DawidAntosz/Spider_Robot_Project/README.md

# Spider Robot Project

<p align="center">
  
</p>

## Description
Robot design from years 2018/19 hence significant shortcomings in this design especially in the documentation and the written program. More information in the documentation directory.

Link to video project:

(https://youtu.be/R4VyKKDyfdw "Video")

<p align="center">
  
  
</p>

<p align="center">
  
</p>
<p align="center">
  
</p>

Project has won many awards, including a particularly distinguished third place in a national competition.

<p align="center">
  
  
</p>
