DawidAntosz/Spider_Robot_Project/Documentation/PAJĄK MECHATRONICZNY.pdf

# PAJĄK MECHATRONICZNY

## Spis treści:

1. Opis projektu
2. Wykaz elementów
3. Schemat połączeń elektrycznych
4. Instrukcja obsługi
5. Zdjęcia
- Modele 3D
- Symulacji w Python
- Rozpoznawania obiektów
- Transmisji wideo online
- Robot
6. Komunikacja w sieci komputerowej, protokół SSH
7. Magistrala I²C
8. Obliczenia oraz opis kinematyki robota
9. Wykrywanie obiektów
10.Zastosowanie w przemyśle
11.Program Arduino
12.Program symulacji w języku Python 13.Program komunikacja Arduino z Raspberry

## 1.Opis projektu

Projekt ten świetnie wykorzystuje połączenie elementów mechanicznych, współpracujących ze sobą komponentów elektronicznych oraz oprogramowania, w tym sensie czyniąc pozycję wartą dalszej lektury.

Przedstawiony robot kroczący wykorzystuje do realizacji ruchu operacje macierzowe dzięki którym może precyzyjnie określić pozycję i orientację każdego z członów robota w przestrzeni trójwymiarowej. Takie rozwiązanie realizacji ruchu jest aktualnie
wykorzystywane wśród wielu robotów przemysłowych.

Składający się z dwunastu serwomechanizmów sterowanych popularnym modułem Arduino Mega bazującym na mikrokontrolerze AVR ATmega2560, który z kolei połączony przez magistrale I²C z minikomputerem Raspberry Pi Zero WH z zamontowana kamerą na pokładzie umożliwia nam zarówno sterowanie robotem jak i dostęp do obrazu przed robotem, w czasie rzeczywistym z lekkim opóźnieniem z dowolnego miejsca w zasięgu naszego routera.

Dodatkowo nasz robot potrafi z dostarczanego przez kamerę obrazu wykrywać obiekty i je rozpoznawać. Metoda wykrywania obiektów należy do metod opartych na głębokim uczeniu się. Wykorzystuje do tego celu otwarto źródłową bibliotekę programistyczną napisaną przez Google Brain Team, nazwaną TensorFlow, która to właśnie wykorzystuje sztuczne sieci neuronowe, które mogą wydobywać z danych zawartych w dostarczanym obrazie wzory oraz modele rozpatrywanego przedmiotu.

Konstrukcja robota została w całości zaprojektowana w programie Inventor Autodesk i wykonana w technologii druku 3D. Materiał jaki został użyty do tego celu to ABS, znacznie bardziej odporny na wyższą temperaturę, przez co też łatwiejszy w obróbce ręcznej. Jedną z zalet tego materiału jest także dość duża odporność na pęknięcia i stosunkowo duża twardość przez co wybór padł na ten rodzaj materiału.

Dodatkiem do kamery jest płytka na której zamieszczone jest sześć diod świecących, dzięki czemu kamera z w przypadku braku światła dalej może wysyłać obraz. Dzięki fotorezystorowi zamieszczonemu nad kamerką można określić graniczną wartość napięcia, które przepuszcza nasz element światłoczuły wprost proporcjonalnie do natężenia oświetlenia w otoczeniu przy której diody zaczynają świecić.

## 2.Wykaz elementów

- Rasberry Pi Zero WH - model togo minikomputera posiada procesor Broadcom BCM2835 1 GHz i 512 MB pamięci RAM dodatkowo został wyposażony w moduł Wi-Fi, Bluetooth, czterdzieści pinów ogólnego przeznaczenia oraz złącze kamery CSI . System operacyjny jaki został użyty to Linux, a wchodząc w szczegóły jedna z dystrybucji Linuxa oparta na Debianie jaką jest Raspbianstretch.
- Arduino Mega 2560 – Jedna z wersji popularnego Arduino płytka posiada mikrokontroler ATmega2560, do wykorzystania 256 kB pamięci Flash, 8 kB RAM, 54 cyfrowych wejść/wyjść z czego 15 można wykorzystać jako kanały PWM, które zostały użyte do sterowania serwomechanizmami, mamy też 16 wejść analogowych.
- Kamera, którą robot posiada to - Raspberry Pi Camera HD v2, która wyposażona jest w matrycę o rozdzielczości 8 Mpx, wspiera tryb nagrywania HD 1080p, 720p oraz 640 x 480p, potrafi wykonywać zdjęcia w jakości 3280 x 2464 px. Raspberry posiada sprzętowe wsparcie dla obsługi tej kamery, dzięki temu urządzenie nie zużywa mocy obliczeniowej procesora. Nie wymaga instalacji sterowników dla systemu Raspbian.
- Serwomechanizmy użyte w projekcie to konkretny model -Serwo PowerHD HD-1800A ich napięcie zasilania jest w zakresie od 4,8 V do 6,0 V. Zakres ruchu: od 0 ° do 180 °. Moment siły oraz prędkość zależy od parametrów zasilania w robocie zasilanie dla serwomechanizmów ustawione jest na 6,0V z tego względu aby uzyskać większy moment, co też daje nammoment siły: 1,3 kg*cm (0,12 Nm) oraz prędkość: 0,08 s/60°. Robot posiada ich w sumie dwanaście, a na każdą nogę przypada ich trzy.
- Zasilanie. Za źródło zasilania posłużyły mi ogniwa litowo-polimerowe. Połączenie ogniw w sposób2S2P, dzięki temu uzyskuje napięcie około 8,0V i pojemność 3Ah
- Przetwornice napięcia - Arduino a także Raspberry potrzebują do pracy napięcia 5,0V. Serwomechanizmy tak jak już wcześniej wspomniałem pracują przy 6,0V chociaż przy wyższym napięciu nic im się złego nie dzieje to jednak z tego względu, że podczas projektowania mogło dojść do zablokowania którejś z nóg, w wyniku czego przy wyższym napięciu układ sterowniczy takiego serwomechanizmu mógł się uszkodzić, wynikła konieczność użycia dodatkowych dwóch przetwornic step-down, które obniżają napięcie zasilania do poziomu pożądanego.
- Dwa przełączniki, jeden służy do załączenia zasilania na obydwie przetwornice tym samym zasilamy już Arduino i Raspberry, z kolei drugi przepuszcza nam napięcie z przetwornicy 6,0V do zasilania serwomechanizmów, takie rozwiązanie pozwala nam na odłączenie serwomechanizmów w dowolnym momencie bez konieczności wyłączania Raspberry.
- Fotorezystor 5-10kΩ GL5616

## 3.Schemat połączeń elektrycznych

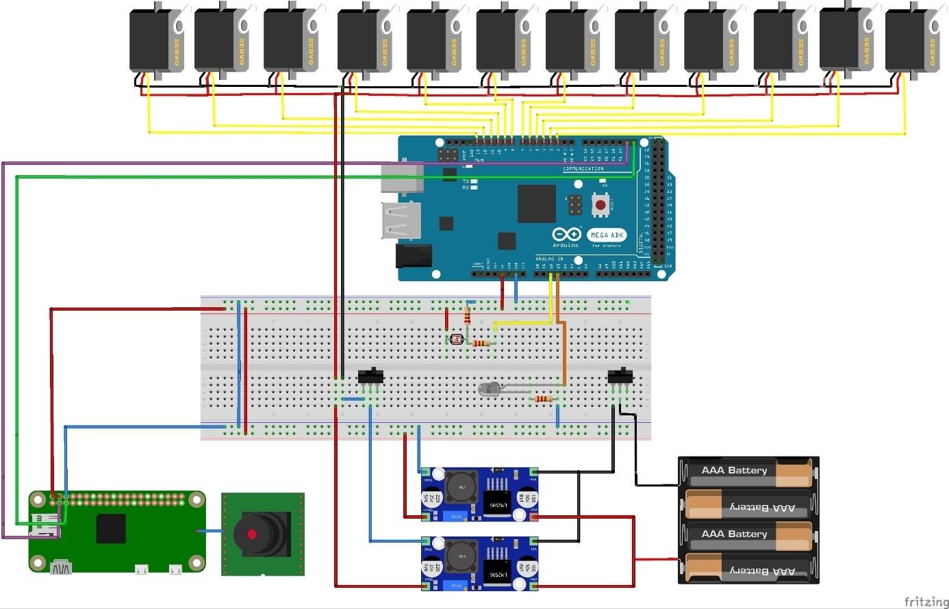
[picture p1: figure]

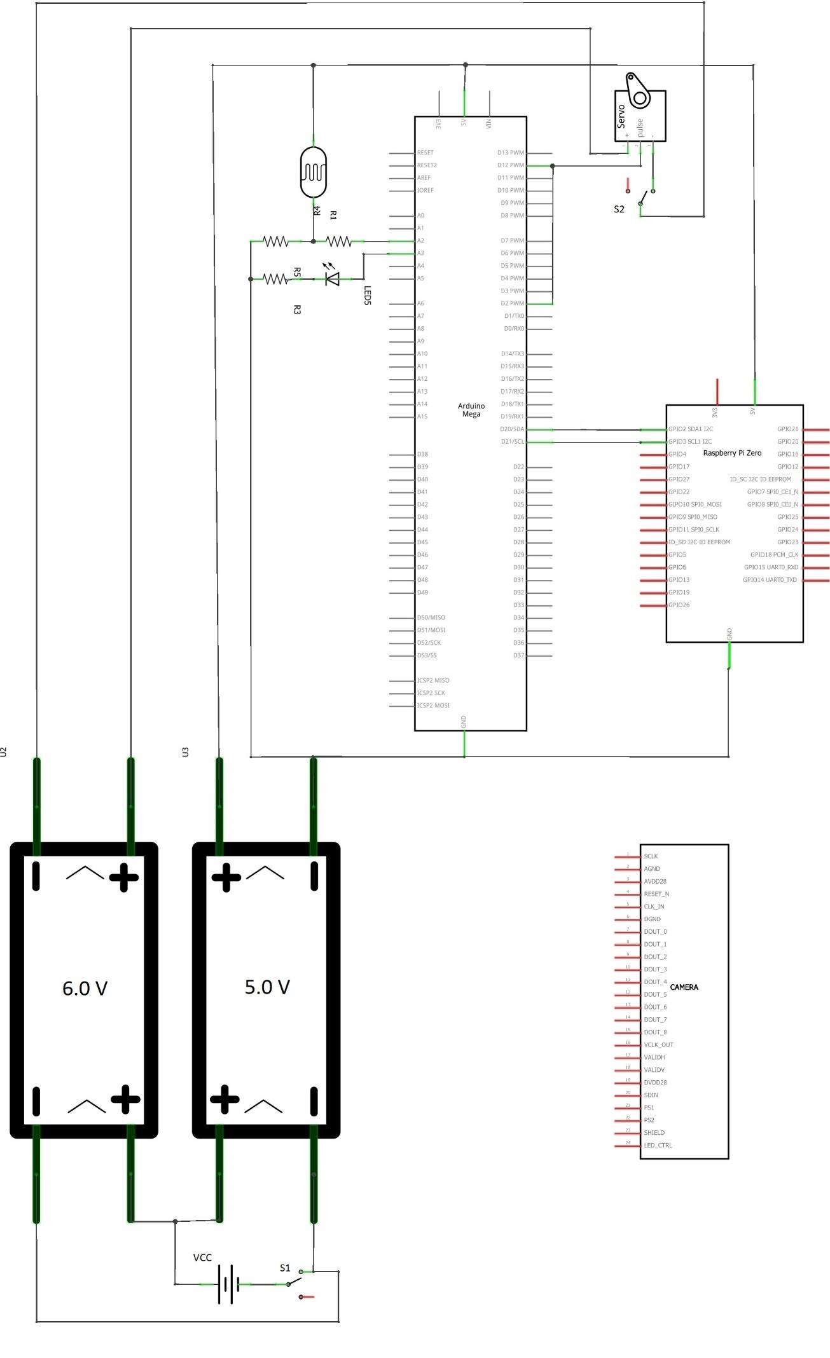
[picture p2: figure]

## 4. Instrukcja obsługi

a. Aby uruchomić robota musimy przełączyć dwa przełączniki znajdujące się w górnej części korpusu.
b. Żeby nawiązać połączenie z Raspberry potrzebujemy mieć na swoim komputerze zainstalowany program do komunikacji PuTTY. (https://www.chiark.greenend.org.uk/~sgtatham/putty/latest.html) Putty to standarowy klient SSH na systemy Windows/Linux , służy do terminalowego łączenia się ze zdalnymi komputerami.
c. Kolejno co musimy zrobić to dowiedzieć się jaki adres IP ma nasz minikomputer, wchodzimy w menu start i wpisujemy cmd potwierdzamy Enter, kiedy otworzy nam się konsola wpisujemy „ arp -a ” wtedy wyświetlają nam się adresy IP wszystkich podłączonych urządzeń z naszym routerem. Raspberry rozpoznamy po adresie Mac, który będzie zaczynać się od ciągu„b8-27-eb”.
d. Kiedy wiemy już jaki adres IP ma Raspberry włączamy program Putty. Domyślnie mamy ustawioną pierwszą z kategorii oraz zaznaczone SSH. W linijce pod nazwą „Host Name” wpisujemy adres IP naszego Raspberry i potwierdzamy Enter.
e. Gdy Raspberry nawiąże komunikacje z naszym komputerem musimy się do niego zalogować. Login „pi” hasło „8054”, po chwili otworzy nam się konsola.
f. Aby móc sterować robotem wpisujemy w konsoli „python ardu.py” uruchomimy program, który służy do komunikacji miedzy Arduino i Raspberry, który również jest dołączony do dokumentacji.
g. Uruchomionym programem możemy sterować ruchem robota wpisując, co chcemy żeby robot zrobił i zatwierdzamy Enter.
- „w” / „s” – idź do przodu /idź do tyłu
- „a” /d” – idź w lewo / idź w prawo
- „z”/ „x” – siedź / wstań
- „c”/ „n” – pomachaj
- „m”/ „l”– przód / dół do góry
- „z” – robot wykonuje przykładową sekwencje ruchów
- „f” – pozycja początkowa
- „v”- wyłączamy program
h. Wpisując w przeglądarce internetowej „IP Raspberry:8081” i potwierdzając Enter ładuje nam się obraz z kamerki robota. Usługa została tak ustawiona, aby uruchamiała się zaraz po starcie systemu. Możemy ją wyłączyć wpisując w konsoli – „sudo service motion stop” aby ponownie uruchomić wpisujemy to samo tylko zamiast „stop” wpisujemy „start” przydatne jest czasem także zrestartowanie usługi wiec, żeby to zrobić postępujemy tak samo tylko końcówka „restart”.
i. Jeśli chcielibyśmy uruchomić rozpoznawanie obiektów musimy zainstalować protokół VNC. (https://www.realvnc.com/en/connect/download/viewer/) Służy on do wirtualnego przekazywania obrazu pulpitu Raspberry. Kolejno wpisujemy adres IP i logujemy się gdy już otworzy nam się pulpit naszego minikomputera w lewym górnym rogu znajdziemy coś na wzór menu, potwierdzamy, wchodzimy w zakładkę „System tools” i wybieramy „UXterm” w podpunkcie zdjęcia dałączam screena.
j. Otworzy nam się terminal. Aby go uruchomić musimy przede wszystkim wyłączyć nasz obraz z kamerki na przeglądarce kamera musi być zwolniona z jakichkolwiek procesów. Tak więc „sudo service motion stop” kolejno wpisujemy dwie komendy – „cd tensorflow1/models/research/object_detection” wchodzimy tym samym w folder z programem „Object_detection_picamera.py”. Jeśli chcemy z tego folderu wyjść wystarczy wpisać „cd”. Gdy jesteśmy już w folderze to prawie identycznie jak programem do sterowania uruchamiamy „python3 Object_detection_picamera.py” po chwili otwiera nam się okno z obrazem z przed kamery… tutaj już ciężko jest mówić o sam obraz jest to bardziej to co komputer rozpoznał poprzez swoje algorytmy.
k. Aby wyłączyć program najeżdżamy na krzyżyk okna programu, następnie klikamy w okno konsoli i wciskamy Ctr+Z.
l. Raspberry wyłączamy poprzez wpisanie w konsoli „sudoshutdownnow” bądź w menu start na dole znajdziemy „Shutdown”.

## 5. Zdjęcia

## - Modele 3D

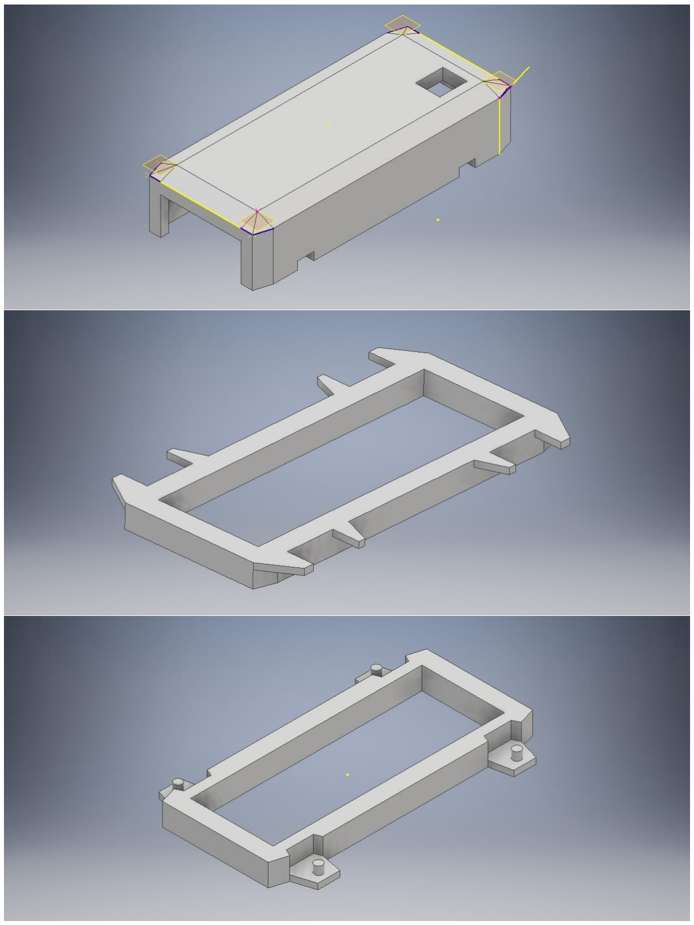
[picture p3: figure]
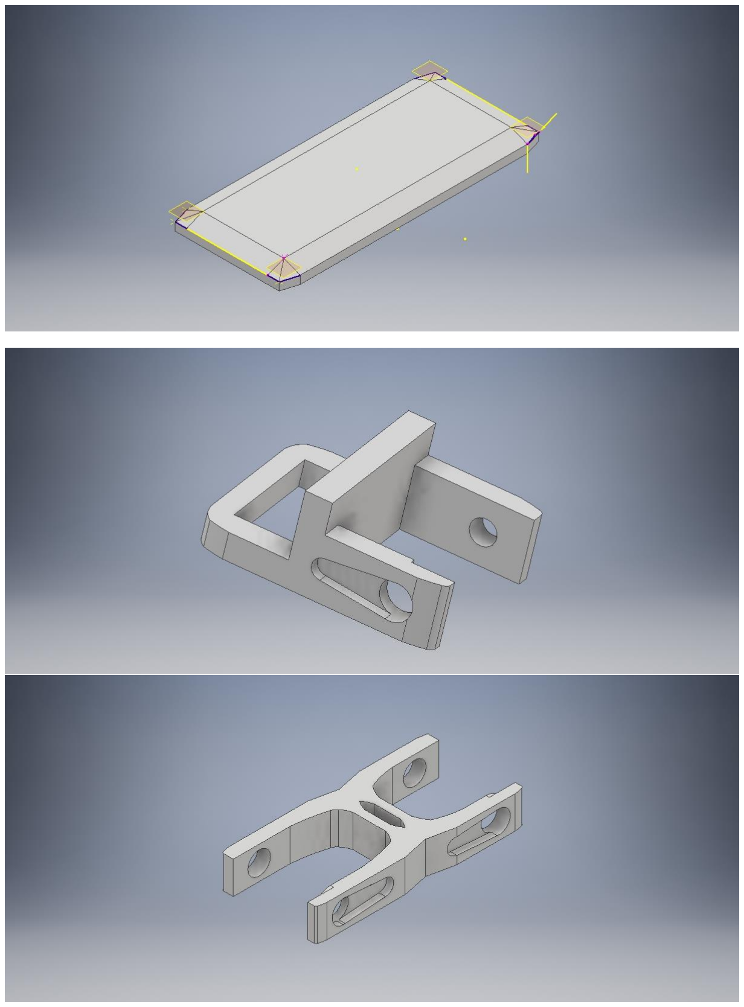
[picture p4: page 12]

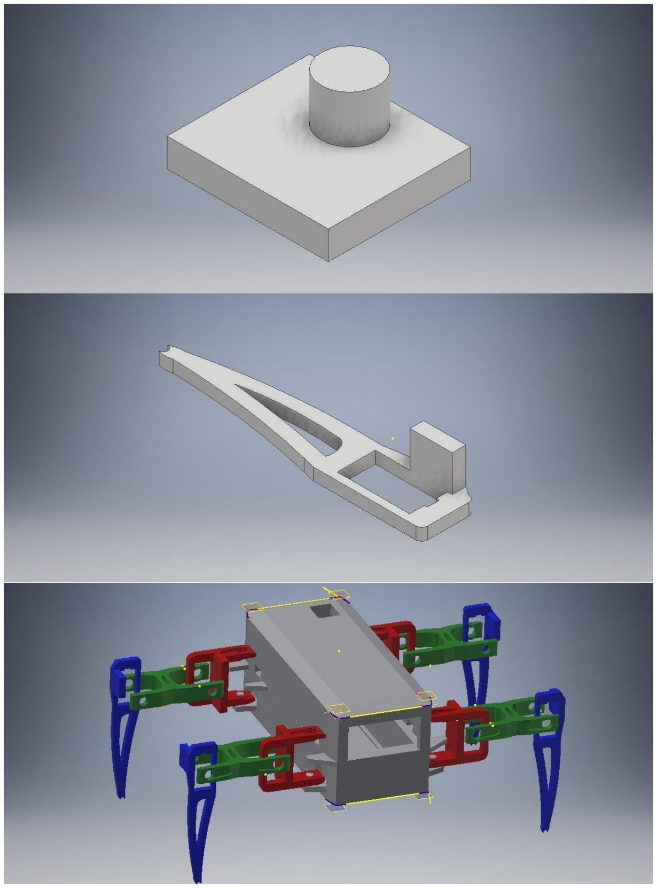
[picture p5: figure]

## - Symulacja w Python

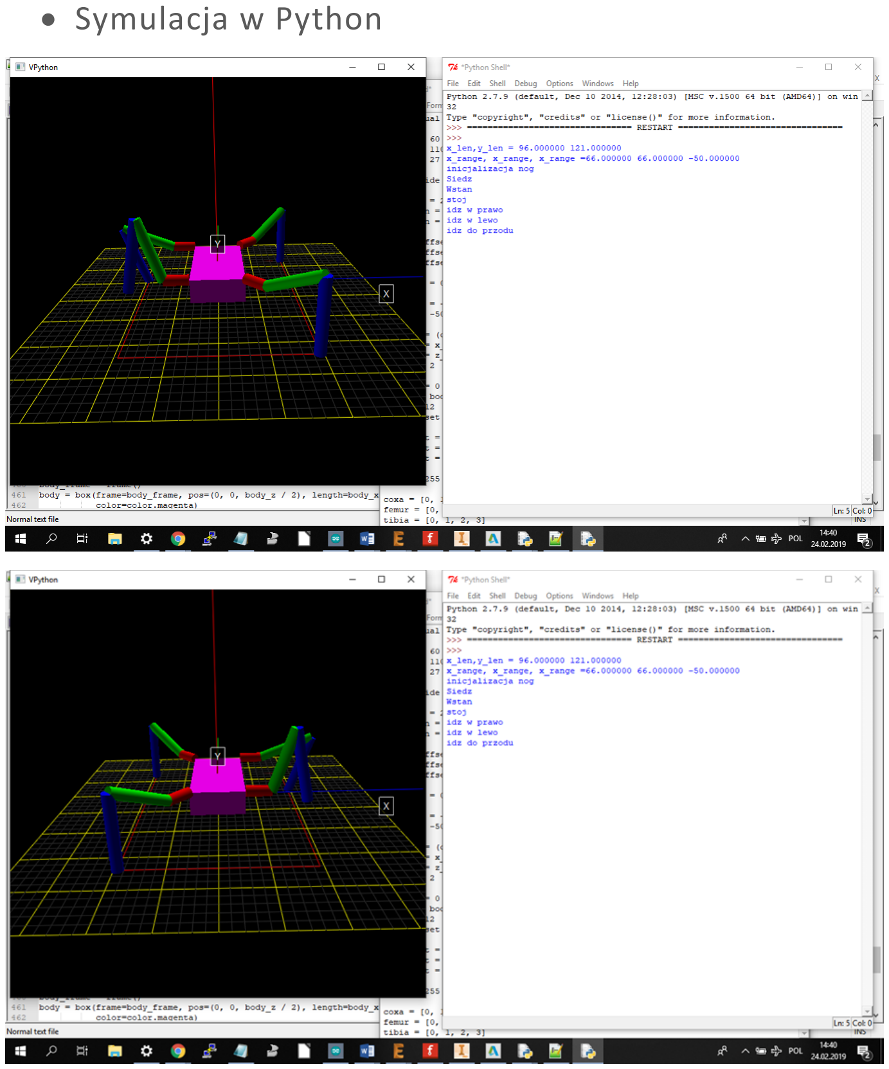
[picture p6: page 14]

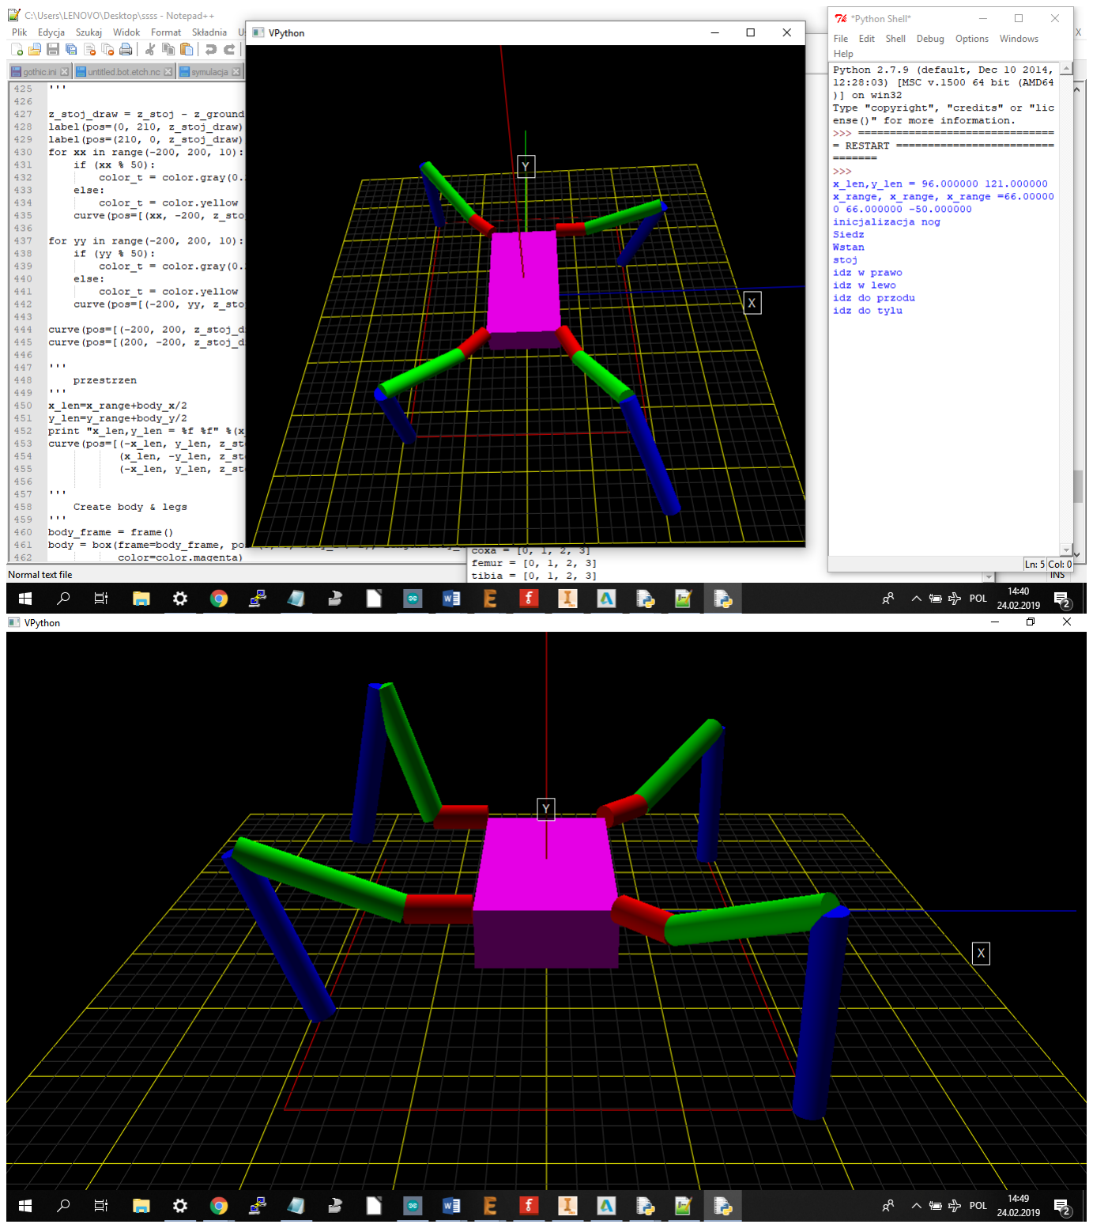
[picture p7: figure]

## - Rozpoznawanie obiektów

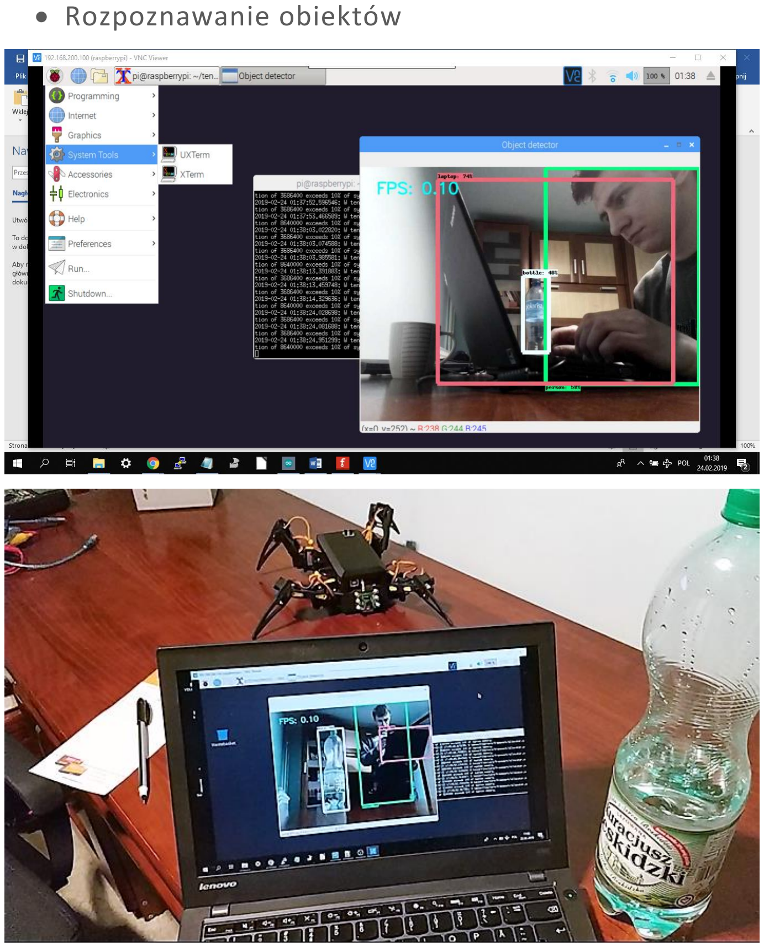
[picture p8: page 16]
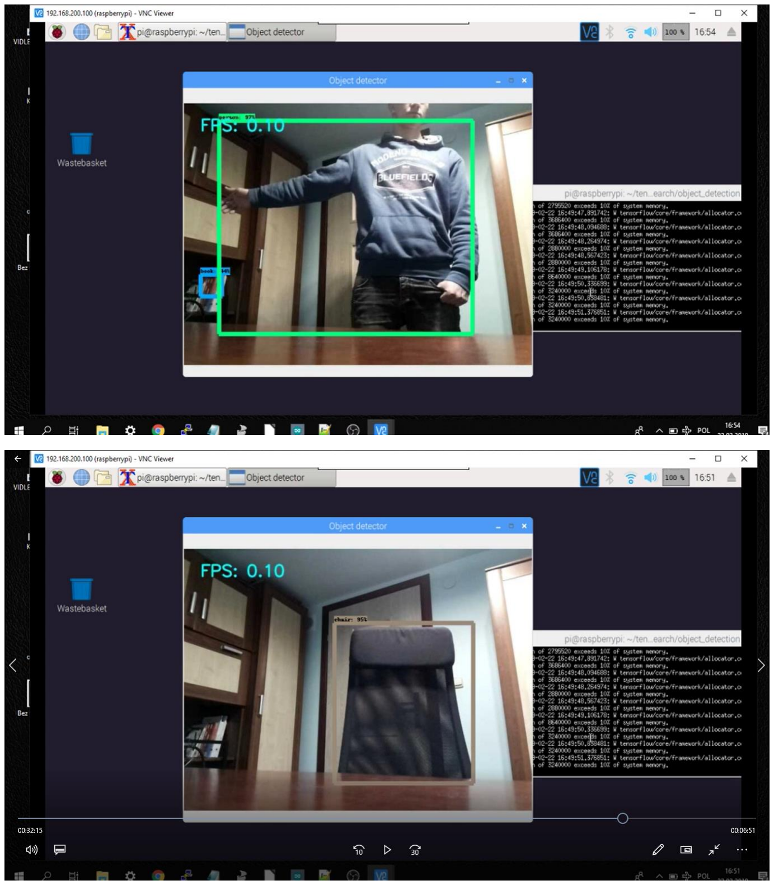
[picture p9: page 17]

## - Transmisja wideo online

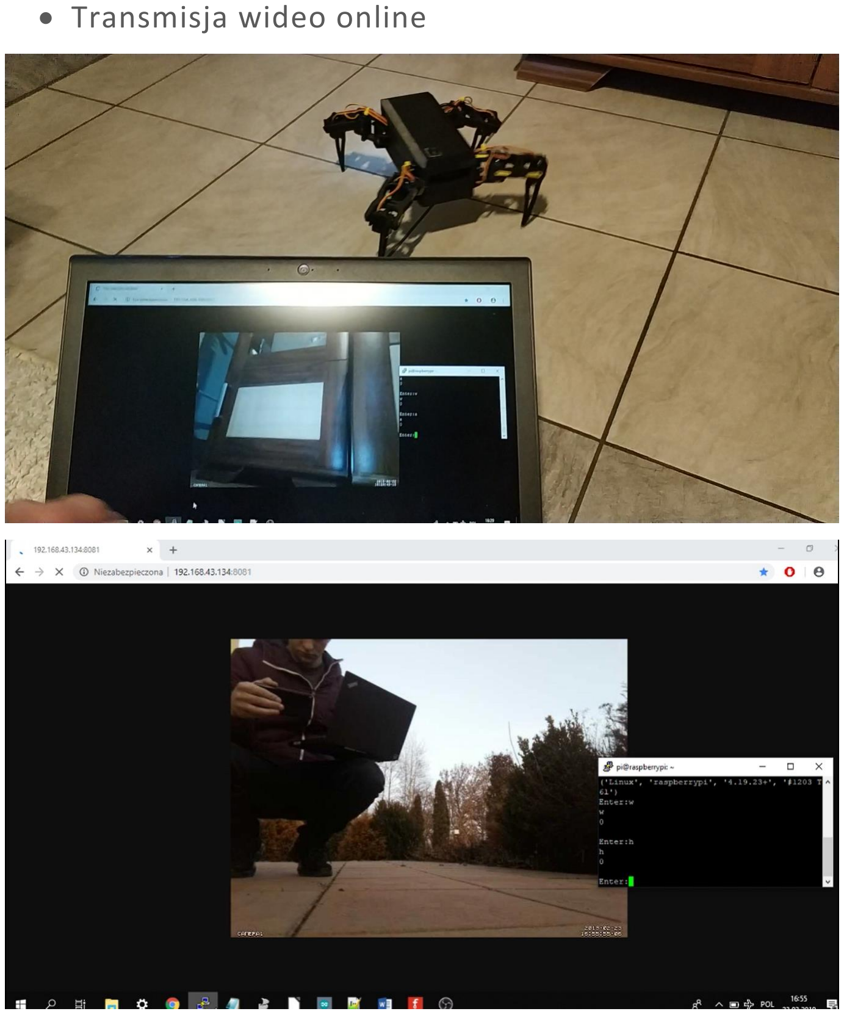
[picture p10: page 18]
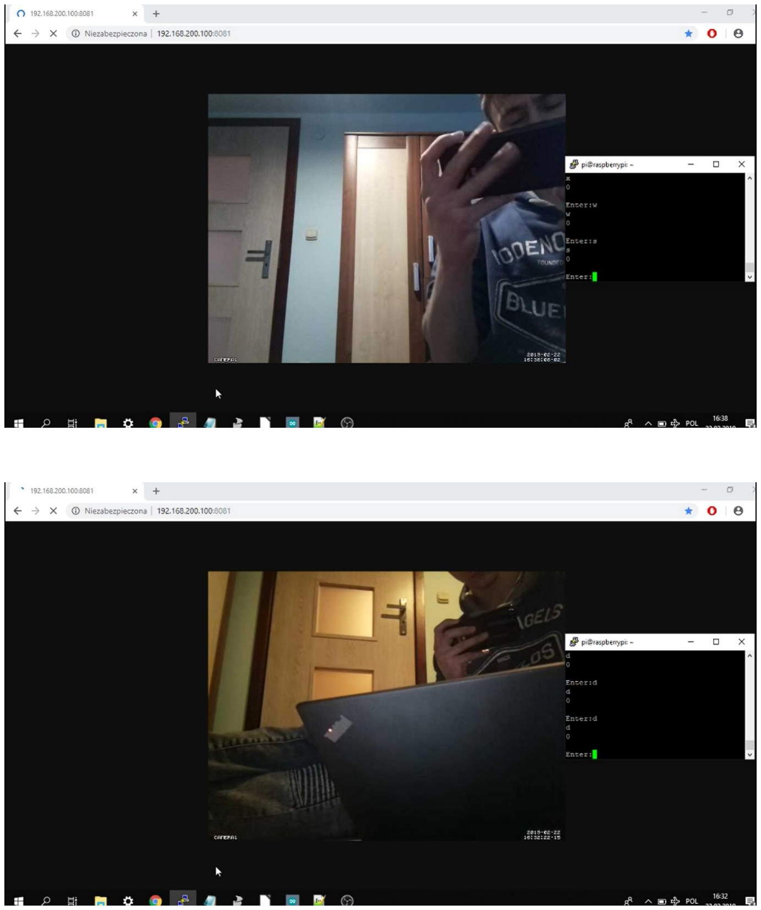
[picture p11: page 19]

## - Robot

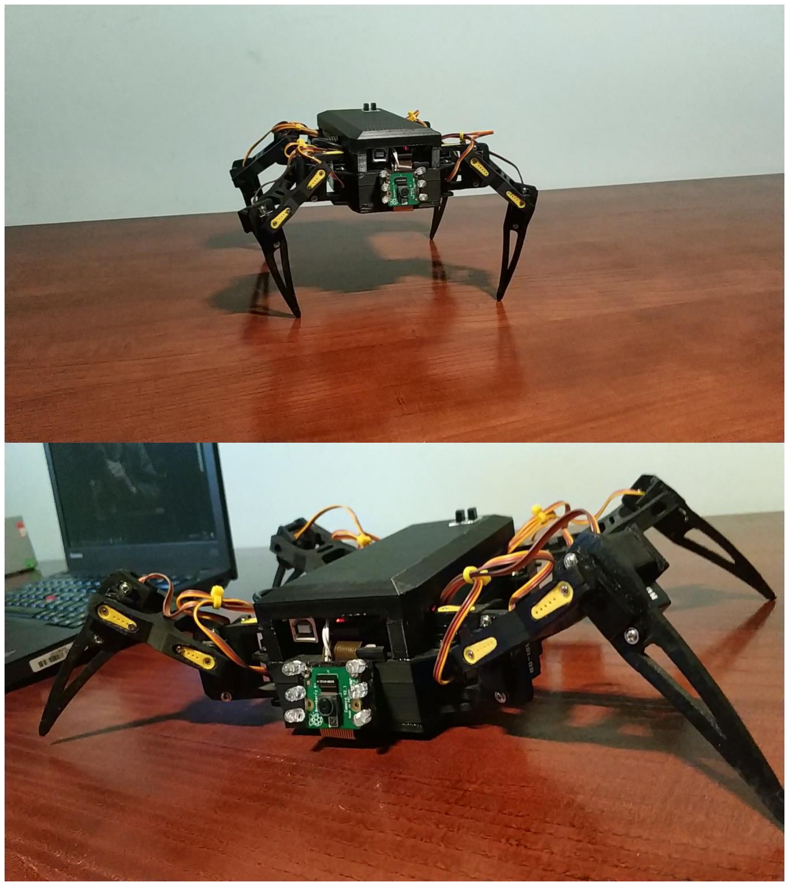
[picture p12: figure]

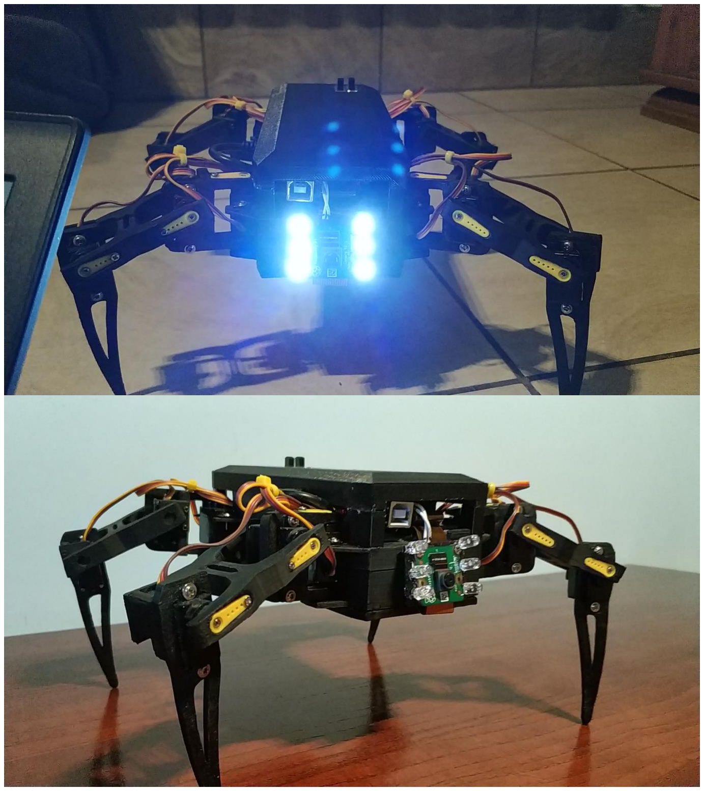
[picture p13: figure]
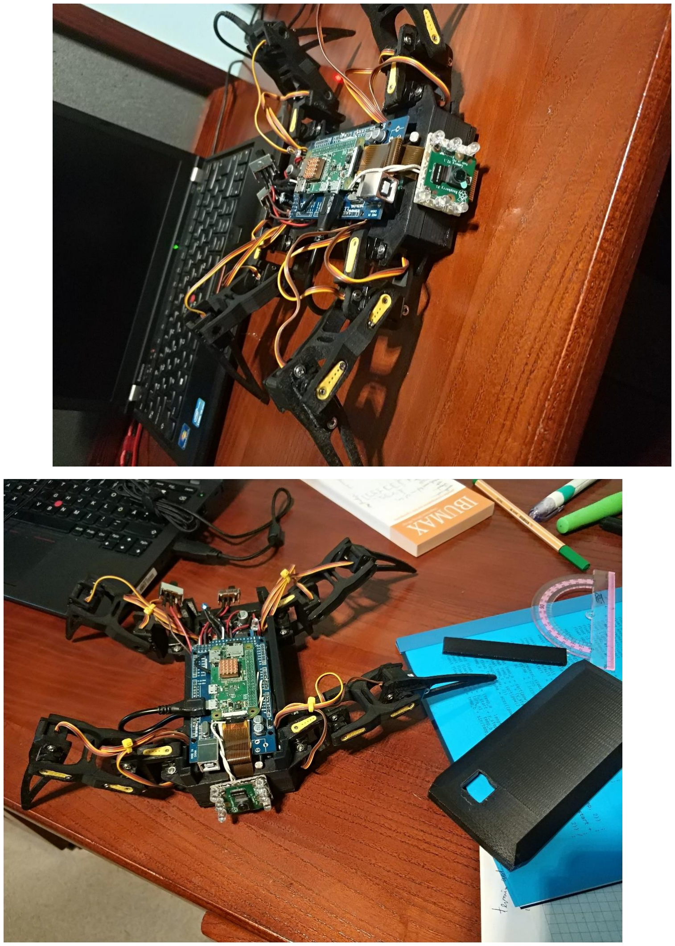
[picture p14: page 22]

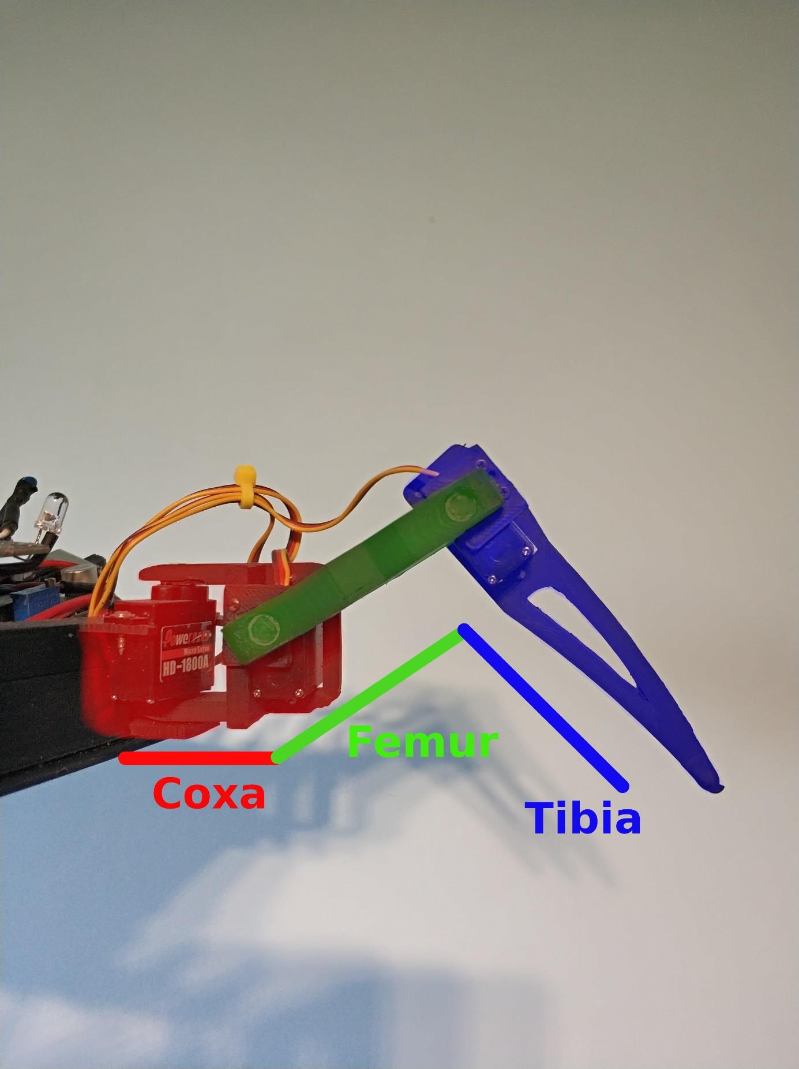
[picture p15: figure]

## 6.Komunikacja w sieci komputerowej, protokół SSH

Często wykorzystywany protokół warstwy aplikacji, to protokół zdalnego zarządzania hostami, zwany SSH. Jest to standardowy protokół komunikacyjny używany w sieciach komputerowych TCP/IP. SSH jest następcą protokołu Telnet i służy on do terminalowego łączenia się ze zdalnymi komputerami. SSH różni się od Telnetu tym, że transfer wszelkich danych jest zaszyfrowany oraz możliwe jest rozpoznawanie użytkownika na wiele sposobów.

W projekcie program, w którym nawiązuje komunikacje z Raspberry nazywa się PuTTY. PuTTY emuluje terminal tekstowy, co pozwala w łatwy sposób łączyć się z serwerem za pomocą wybranego protokołu jakim jest SSH.

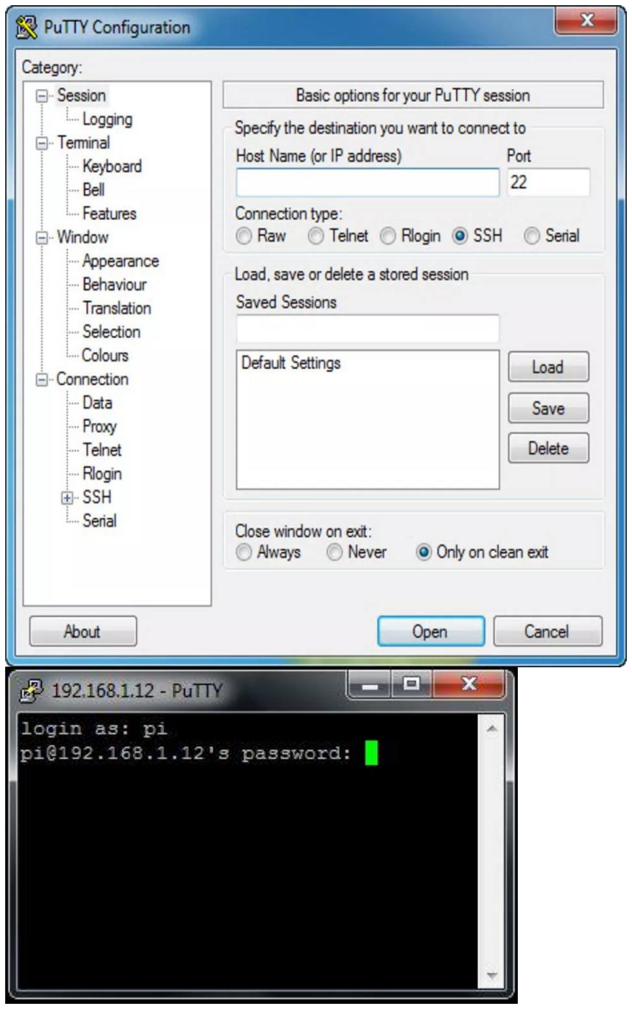
[picture p16: figure]

## 7. Magistrala I²C

Połączenie Arduino z Raspberry wydaje się być najbardziej przestronne jeśli chodzi o możliwości jakie przez integracje tych dwóch platform możemy uzyskać, ale również takie zestawienie jest najbardziej budżetowym rozwiązaniem.

Bardzo popularny interfejs komunikacyjny jakim możemy obsłużyć za pomocą tylko 2 linii aż 127 urządzeń jest I²C.Magistrala I²C to szeregowa dwukierunkowa magistrala służąca do przesyłania danych. Korzysta ona w tym celu tylko z dwóch pinów co jest oczywistą zaletą tego sposobu komunikacji. SCL -pin przez który przesyłany jest sygnał zegarowy, SDA - pin przez który przesyłane są dane.

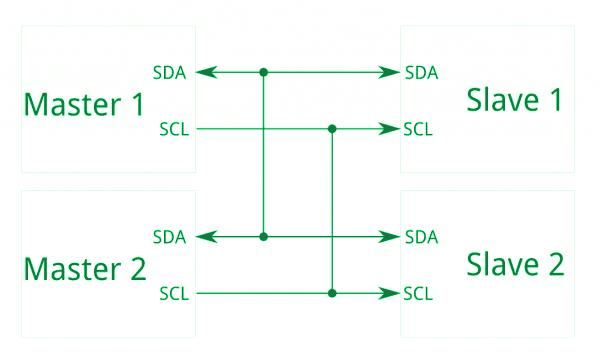
[picture p17: figure]

Magistrala I²C przesyła dane w sposób synchroniczny, synchronizowany za pomocą sygnału zegarowego podawanego na pinie SCL. Komunikacja I²C działa w układzie Master, Slave, to znaczy że jedno urządzenie jest nadrzędne i steruje urządzeniem podrzędnym, które ma określony adres do którego Master czyli nasze urządzenie nadrzędne musi się odnieść. Możliwe jest przez to sterowanie wieloma urządzeniami podrzędnymi. W programie dla Arduino funkcja która odbiera dane spod zdefiniowanego wcześniej adresu nazywa się „receiveEvent” i odbiera dane w postaci koduASCII czyli siedmiobitowego systemu kodowania znaków, używanego aktualnie we współczesnych komputerach.

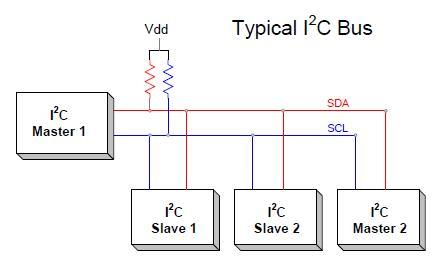
[picture p18: figure]

## 8.Obliczenia oraz opis kinematyki robota

Tak jak na wstępie zostało wspomniane, robot do realizacji ruchu korzysta z operacji matematycznych, przez które za pomocą macierzy przedstawia algorytm przemieszczenia, umożliwiając wyznaczenie położenia punktu końcowego w przestrzeni trójwymiarowej przechodząc przez poszczególne punkty pośrednie.

W robotyce bardzo często wykorzystuje się notację Denavita-Hartenberga umożliwia nam ona wyznaczenie równań kinematyki robota znając dane o zmiennych przegubowych możemy określić orientacje końcówki roboczej.

Wyznaczenie pozycji i orientacji chwytaka na podstawie współrzędnych przegubowych to zadanie proste kinematyki. Najłatwiej będzie zacząć od przedstawienia tak prostego manipulatora dwuczłonowego.

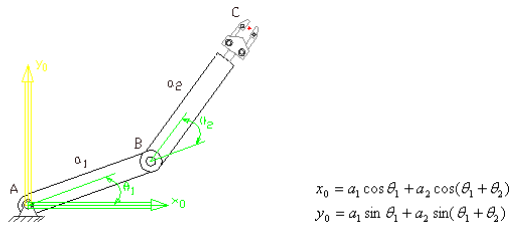
[picture p19: figure]

Przedstawione działania pozwalaja określić położenie punktu C dla poszczególnych osi X0 i Y0 znajac kąty oraz długoście poszczególnych członów manipulatora.

Gdybyśmy chcieli rozważyć ten sam problem stosując notację Denavita-Hartenberga musielibyśmy wyobrazić sobie dodatkową oś Z0 w naszym układzie współrzędnych oraz dodatkowe układy współrzędnych znajdujące przy każdym z członów robota.
Jedną z zasad jakie musimy przyjąć to ta, że obrót poszczególnych członów ramienia odbywa się względem osi Z, a przemieszczenie względem osi Z, a X.

Zgodnie z notacją należy przygotować tabele wraz z wypisanymi z parametrami kinematycznymi, takimi jak kąty obrotu, przemieszczenia członów oraz długości poszczególnych ramion. Przy parametrach które ulegają zmianie w czasie znajduje się indeks var.

Połączenie | tii | Di | Ai | αi
1 | ti1, var | 0 | A1 | 0

2 | ti2, var | 0 | A2 | 0

Rozpatrywany przez nas manipulator płaski o dwóch stopniach swobody musimy przesunąć pomiędzy poszczególnymi układami współrzednych, tak aby pomiedzy tym przesunięciem był tylko jeden parametr zmienny, a kolejno musimy rozpisac macierze przekształcenia jednorodnego dla poszczególnych członów, a wyglądaja one tak.

Dla pierwszego połączenia

Dla drugiego połączenia

Mając zdefiniowane dwie macierze dla poszczególnych połączeń możemy ostatecznie wyciągnąć macież transformacji bedącą główną macieżą układu Y0 X0

Porównując równania przytoczone na samym początku możemy wywynioskować, że położenia chwytaka z obliczeń wychodzą identyczne jak w przypadku naszej wyjsciowej macierzy.

Na tym relatywnie prostym przykładzie na chwilę przystaniemy abym mógł przytoczyć całościową macierz ruchu naszego robota, która jest bogatsza o macierz ruchu wektora w przestrzeni euklidesowej to znaczy, że uwzględnia odwrócenia punktu docelowego,a odwrócenie, punktu może zmienić chiralność, to znaczy zmienić prawy układ współrzędnych na lewy układ współrzędnych lub też na odwrót.

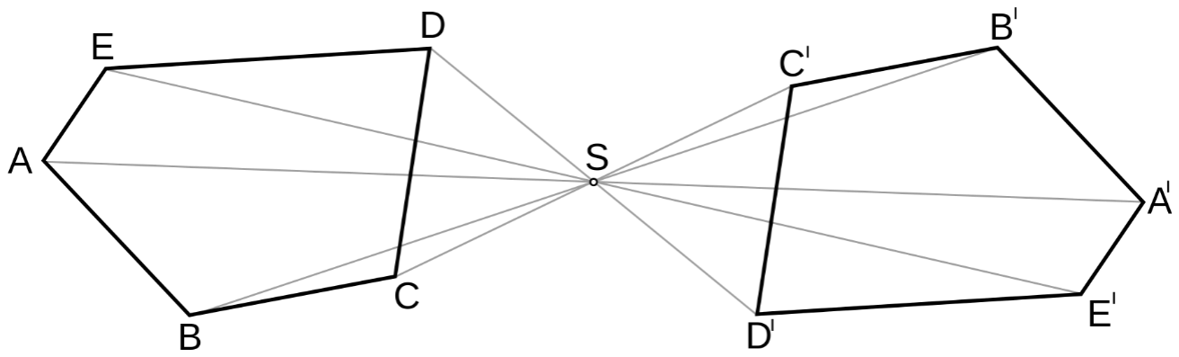
[picture p20: figure]

Cała rotacja plus inwersja tworzy zbiór macierzy ortogonalnych.

Tak całościowo już po wszelkich przejściach wygląda macierz robota

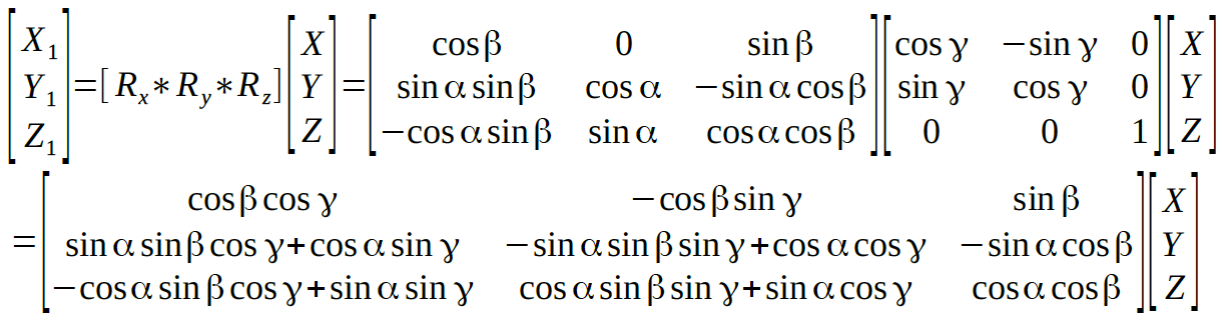
[picture p21: figure]

Obrót elementarny, czyli taki wokół dowolnej osi układu współrzednyc wygląda tak:

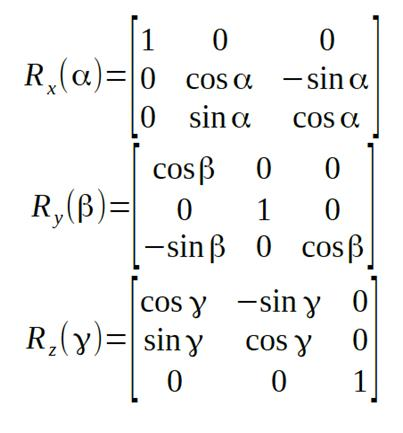
[picture p22: figure]

Każda z tych macierzy obraca wektory kolumnowe przeciwnie do ruchu wskazówek zegara, jeśli spełniony jest któryś z warunków: oś obrotu kieruje się w stronę obserwatora, układ współrzędnych jest prawoskrętny, kąt obrotu ti jest dodatni.

Program jaki obsługuje Arduino znajduje się w „Załaczniku 1”. Z racji tego, że kod jest dość długi i mimo starań nie jest na tyle klarowny by zrozumieć go od ręki, jego tok postępowania pozwolę sobie rozwinąć po krótce w tym miejscu.

Myślę że najwygodniej będzie zacząć patrząc już od elementu wykonawczego, serwomechanizmy swoje położenie wyznaczają poprzez odbiór co 20 ms sygnału długości 900-1500ms i ustawiają się stosownie do długości impulsu. Tak więc mamy zdefiniowaną tablicę, w której są wpisane nazwy pinów do których są podłączone serwomechanizmy „servo_pin[4][3]”. Właśnie na te piny przypisywane są określone wartości przez funkcje „biegun_dla_serw”. Funkcja ta pobiera dane takie jak alpha, beta, gamm, które są danymi przeliczonymi ze współrzednych kartezjańskich na biegun, to znaczy na odpowiednią wartość, którą możemy serwo ustawić. Funkcją odpowiadającą za wyliczenia danych takie jak, alpha, beta, gamma nazywa się „kartezjanski_na_biegunowy” i wykonuje potrzebne do tego obliczenia. Obie te funkcje są wywoływane przez funkcje „Serwa”, w której wywołana jest funkcja przerwań ustalająca w jakim czasie ma wykonać się przemieszczenie oraz ustawione zmienne statyczne, czyli widoczne tylko dla tej funkcji alpha, beta, gamma. Przez porównanie położeń funkcja przepisuje właśnie wartości do powyższych funkcji.

Główna funkcja programu czyli „setup” wpisuje wartości dla położenie początkowego odnosząc się do funkcji „ustawienie ” o której będzie zaraz, czyli po uruchomieniu arduino ustawiane są nogi robota na określone położenie póżniej mamy inkrementacje położenia czyli dla każdej nogi ustawiane jest kolejne położenie mamy tam zapis położenie teraz = położenie właściwe i są to tablice z wartościami kolejnych liczb wywołanych przez inkrementacje w pętli „for” i jest to niejako powielenie funkcji „czekaj” która też będzie omówiona, a na końcu wywołujemy przerwanie w milisekundach dla funkcji „Serwa”. Idąc logiczną kolejnościąw dalszej cześć mamy funkcję, która już dla danego ruchu ustawia poszczególne wartości i nazywa się ona „ustawienie” i właśnie w niej obliczane jest po przyjęciu danych zewnętrznych, które dla określinego ruchu są w nią wpisywane przez sekwencje ruchu jaką chcemy wykonać. Jej nieodłączną funkcją wykonywaną w danej sekwencji ruchu jest funkcja o nazwie „czekaj” i porównuje ona wartości bedące w wewnątrz tablicowych położeniach w danej chwili do położeń pożadanych. W pętli głównej naszego programu najistotniejsze jest postawienie nazwanej przeze mnie „flagowa_przeszkoda” przypisanie do niej jakiejś wartości pozwala na określenie wykonania funkcji.

Pragnę zaznaczyć że wszelkie obliczenia w szerszym aspekcie są zapisane w programie,tutaj jedynie pobieżnie przedstawiam logikę działania.

## 9. Wykrywanie obiektów

W tym podpunkcie na samym początku opiszę jak całościowo zostały zaimplementowane i użyte biblioteki do wykrywania obiektów kolejno wgłębię się w zasadę działania czysto teoretyczną, ponieważ temat jest bardzo rozległy będzie to omówione w znacznym skrócie.

Tak więc jak na samym wstępie było powiedziane, że głównym silnikiem procesu jest biblioteka TensorFlowi, potrafi ona nie tylko rozpoznawać obraz lecz także analizować mowę. Żeby zrozumieć zasadę działania TensorFlow trzeba zapoznać się z teorią grafu skierowanego ilustracja przedstawia właśnie przykładowy graf.

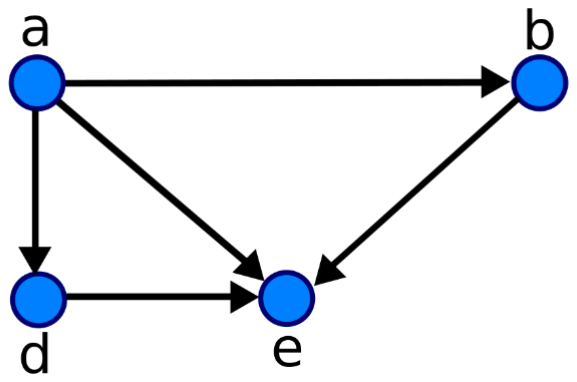
[picture p23: figure]

Jego wierzchołki to matematyczne operacje lub punkty, w których dochodzi do wymiany danych, zaś krawędzie opisują relacje wejścia/wyjścia pomiędzy węzłami, przedstawione w formie dynamicznych wielowymiarowych macierzy danych. Udostępniona przez Google biblioteka programistyczna pozwala na obliczenia numeryczne z wykorzystaniem takich grafów. Można tu korzystać zarówno z ogromnych klastrów superkomputerowych, stacji roboczych z wieloma GPU, jak i wielordzeniowych mobilnych procesorów w smartfonach. Jej twórcy podkreślają, że pozwala na elastyczne przetwarzanie danych bez wnikania w niskopoziomowe szczegóły, Google udostępniło nie tylko samą bibliotekę, ale też modele sieci neuronowych, wyszkolonych do rozpoznawania zdjęć i pisma odręcznego, analizowania tekstu oraz mowy.

Silnikiem odpowiedzialnym za przetwarzanie danych jest TensorFlow jednak on sam nie wystarczy. Niezbędna jest obróbka obrazu posłużyła mi do tego biblioteka również o otwartym kodzie źródłowym OpenCV, została zaprojektowana z myślą o wydajności obliczeniowej i silnym skupieniu się na aplikacjach czasu rzeczywistego. Zakres zastosowań obejmuje zestawy narzędzi 2D i 3D przez przeglądanie map w Internecie czy też właśnie w systemach rozpoznawania twarzy.

Do ważniejszych bibliotek które zostały zaimplementowane muszę zaliczyć jeszcze Protobuf - pełna nazwa to bufor protokołów, służy on do przechowywania oraz wymieniania danych w strukturze danych .

Technika głębokiego uczenia się, która jest zdolna do kompleksowego wykrywania obiektów bez specyficznego definiowania cech opierają się na splotowych sieciach neuronowych. Sieci neuronowe są stworzone na wzór metaforycznie struktur nerwowych, rzeczywistych, biologicznych dobrym określeniem całości jest podejście techniczne do czegoś co jest bardzo biologiczne i inspiracja biologiczna do czegoś co możemy potem wykorzystywać w technice a mam na myśli tutaj ludzki mózg. Operacje jakie są wykonywane w uczeniu maszynowym są bardzo bliskie operacjom wykonywanym przez ludzki układ nerwowy.

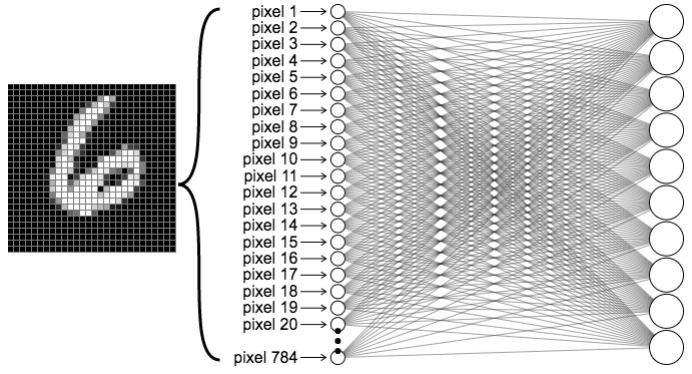
[picture p24: figure]

Sieć neuronowa to połączenie elementów zwanych sztucznymi neuronami, które tworzą co najmniej trzy warstwy: wejściową, ukrytą i wyjściową, przy czym warstw ukrytych może być wiele. Neurony sieci przetwarzają informacje dzięki temu, że podaje się na wejście sieci różne wzorce, a sieć na podstawie różnicy wyniku wyjściowego w stosunku do wzorca modyfikuje wagi połączeń, które modyfikują się podczas działania sieci. Modyfikowanie wag nazywane jest „uczeniem się” sieci.To właśnie w procesie uczeniu się sieci tkwi istota sieci neuronowych. Ponieważ to właśnie modyfikacja wag pozwala metodą prób i błędów uwzględnić końcowy wynik z jak największą trafnością. Sama definicja sztucznej sieci neuronowej brzmi następująco – zbiór prostych jednostek obliczeniowych przetwarzających dane, komunikujące się ze sobą i pracujące ze sobą równolegle. Natomiast pojedynczy neuron jest jednostką obliczeniową zdolną do samodzielnego dokonania szacunku na dany temat przez co jest w pełni funkcjonalną jednostką. Własności neuronu determinuje przyjęta segregacja danych wejściowych oraz założona funkcja wyjściowa.

Jedna z identycznych własności komórki rzeczywistej, a sztucznego neuronu jest posiadanie jednego wyjścia i wielu wejść. Tak też posiadając dane z wielu źródeł ostateczny wynik jest kompensacją tych danych. Wynik wyjściowy podawany jest na wejście kolejnego neuronu tworząc poszczególne warstwy całej sieci.

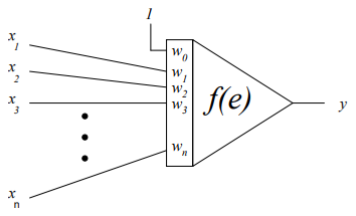
[picture p25: figure]

Widzimy właśnie na zdjęciu graficzną interpretacje pojedynczego neuronu w postaci specyficznego przetwornika sygnału, jak widzimy mamy jedno wyjście, n wejść sygnału wraz z wagami wi , pobudzenie e neuronu czyli suma ważona sygnałów wejściowych oraz funkcję aktywności f(e). Proces uczenia polega na modyfikowaniu wag sieci. Ma to odwzorowanie w schemacie działania naszego umysłu gdzie właśnie modyfikuje on swoje nawyki poprzez różnedoświadczenia. Zasada działania każdego neuronu jest identyczna, a dopiero ze złożoności struktur tworzonych przez miliony komórek wynika specjalizacja mózgu, zdolność nauki, zapamiętywania, rozwiązywania problemów. Całością zajmie się właśnie nasz silnik całego procesu jakim jestTensorflow.

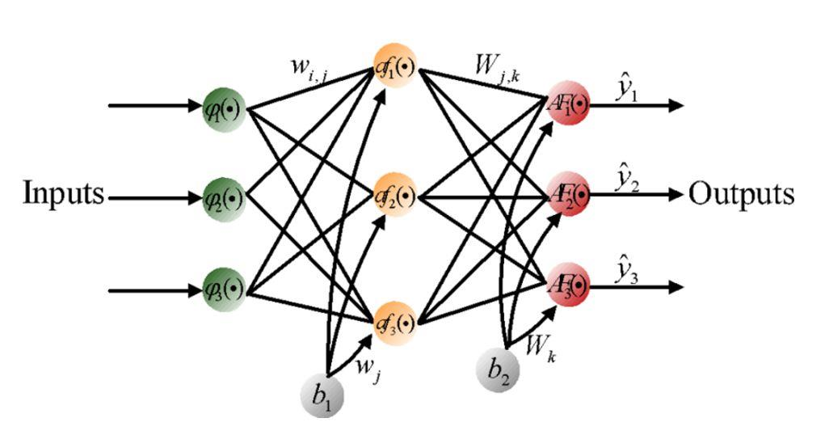
[picture p26: figure]

## 10. Zastosowanie w przemyśle

Obecnie branża technologiczna przechodzi światowy krok naprzód w stronę automatyzacji i robotyzacji przemysłu. Stanowi to znaczącą zmiana dla każdego zakładu niosąc za sobą poprawę i utrzymanie stałej jakości wytwarzanych produktów, znaczący wzrost efektywności linii produkcyjnej oraz zauważalną poprawę bezpieczeństwa stanowisk pracy. Mowa jest o tym tutaj dlatego że to właśnie popularyzacja robotów przemysłowych przyczyniła się do znacznych innowacji w przemyśle.
Omawiane roboty najczęściej występują w postaci mechanicznego ramienia o pewnej liczbie stopni swobody które możemy programowo ustawiać pod wybranym kątem. Środowiska w których są one programowane to w znacznej części uproszczone na korzyść operatora tło złożonego algorytmu do którego operator może wpisać dowolne parametry aby określić punkt w przestrzeni do którego robot końcówką robaczą ma dotrzeć. Tak też programowanie robotów w dużej mierze jest uproszczone i po części intuicyjne.Wgłębiając się w strukturę programu możemy zapoznać się z zasadą według, której robot znając punkt docelowy potrafi wyliczyć po kolei punkty pośrednie po których dotrze do swojego celu. Jest to w dużej mierze rozwijające i pozwala zrozumieć zasadę działania tych maszyn.
Możliwości jakie daje nam współczesna matematyk jak i oprogramowanie komputerowe są nieodłączną częścią tej dziedziny przemysłu, a ich wykorzystanie leży od strony innowacyjności oraz inwencji twórczej człowieka. Robot przedstawiony w projekcie wykorzystuje do realizacji swojego ruchu właśnie jedną z metod opartych na geometrii euklidesowej, przyjmując w tym przemieszczenie się w ortogonalny układzie współrzędnych.

Światowy boom w zakresie innowacji obchodzi w 2012 r. rozwój sztucznej inteligencji, w kolejnych latach przez ulepszanie algorytmów odsetek błędów przy rozpoznawaniu obrazu znacznie spadł. W odniesieniu do naszego robota mamy do czynienia z rozpoznawaniem i opisywaniem obiektów wizualnych. Minikomputer jakim jest Raspberry odpowiednio skonfigurowany potrafi po otrzymaniu próbki obrazu rozpoznać a także podpisać co znajduje się na zdjęciu z dokładnością wyliczonego przez algorytm prawdopodobieństwa procent. Działania jakie wykonuje algorytm oparte są nawielowarstwowej sieci neuronowej. Struktury matematyczne wraz z ich oprogramowaniem pozwalają na wykorzystanie najnowszych technologii w wielu branżach takich jak medycyna, kosmologia czy obsługa klienta. Architektura głęboka osiąga wyniki porównywalne, a w niektórych przypadkach lepsze od ludzkich ekspertów w takich dziedzinach jak rozpoznawanie mowy, obrazu, a po twarzy nawet orientacji seksualnej przetwarzanie naturalnego języka, filtrowanie dźwięku czy filtrowanie w sieciach społecznościowych. Słowem głębokie uczenie pozwala maszynie nie tyle co widzieć ale wiedzieć co widzi. W przemyśle, wizja komputerowa wykorzystywana jest przy procesach produkcyjnych i pozwala przykładowo określić położenie detali.

## 11.Program, Arduino

- Załącznik 1

## 12.Program, symulacji w języku Python

- Załącznik 2

## 13.Program, komunikacja Arduino z Raspberry

- Załącznik 3
