DawidAntosz/Spider_Robot_Project/Program/i2c_communication.py

#!/usr/bin/python
# -*- coding: utf-8 -*-
import smbus
import time

bus = smbus.SMBus(1)

address = 0x04

def writeNumeber(value):
	bus.write_byte(address, value)
	return -1

def readNumber():
	number = bus.read_byte_data(address, 1)
	return number


def main():
	
    while True:
	data = raw_input("Data to sent :")
	data_list = list(data)
	for i in data_list:
		writeNumber(int(ord(i)))
		time.sleep(.1)
	writeNumber(int(0x0A))

	
if __name__ == '__main__':
    main()
